ranotokak/K-controller/pics/20200108_173936.jpg

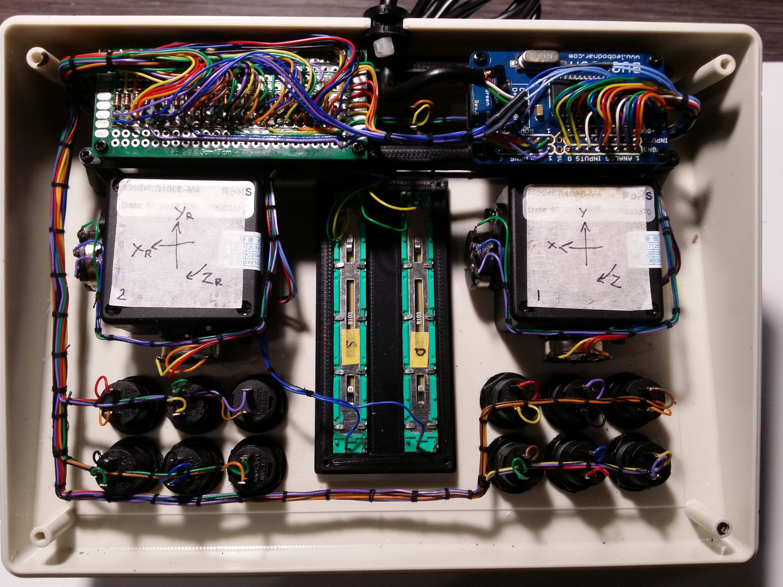
pics/20200108_173936.jpg
