ranotokak/K-controller/pics/20200108_173652.jpg

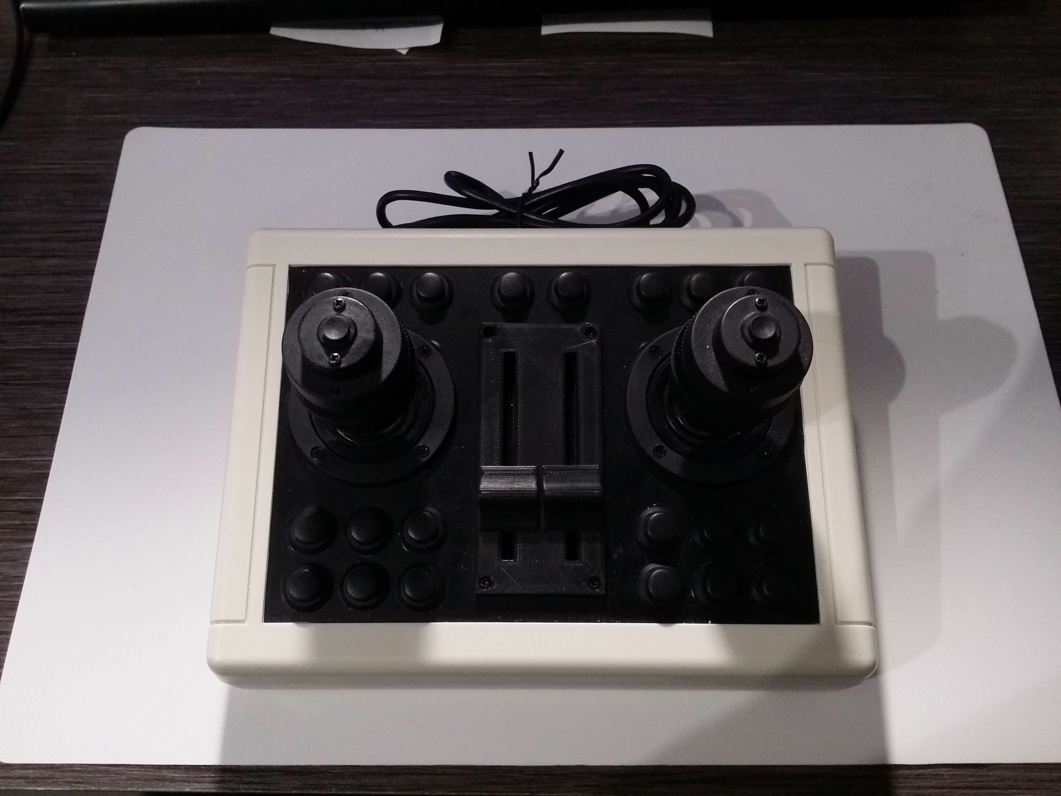
pics/20200108_173652.jpg
