ranotokak/K-controller/README.md

# K-controller
Compact 8 axis game controller for Kerbal Space Program game. Uses two JH-D400X-R4 3 axis joysticks and 2 sliders for control.

* Parts to buy and some links in PartsList.ods
* Read AssemblyNotes.txt before build
