ranotokak/K-controller/PartsList.ods

parts list
BU0836A-NC 12-Bit Joystick Controller No Connectors | http://www.leobodnar.com/shop/index.php?main_page=product_info&cPath=94&products_id=219
Case project box 200*145*63mm | https://www.aliexpress.com/item/32901311993.html
JH-D400X-R4 Joystick | https://www.aliexpress.com/item/32918151242.html
Button Switch 12mm | https://www.aliexpress.com/item/32802331189.html
B10K SC6080GH Potentiometer
3x7cm PCB Breadboard
LL4148 diode
30 AWG 0.25mm wire
M2x10 self-tapping screw
