ranotokak/K-controller/SolidworksFiles/JH-D400X-R4.SLDASM

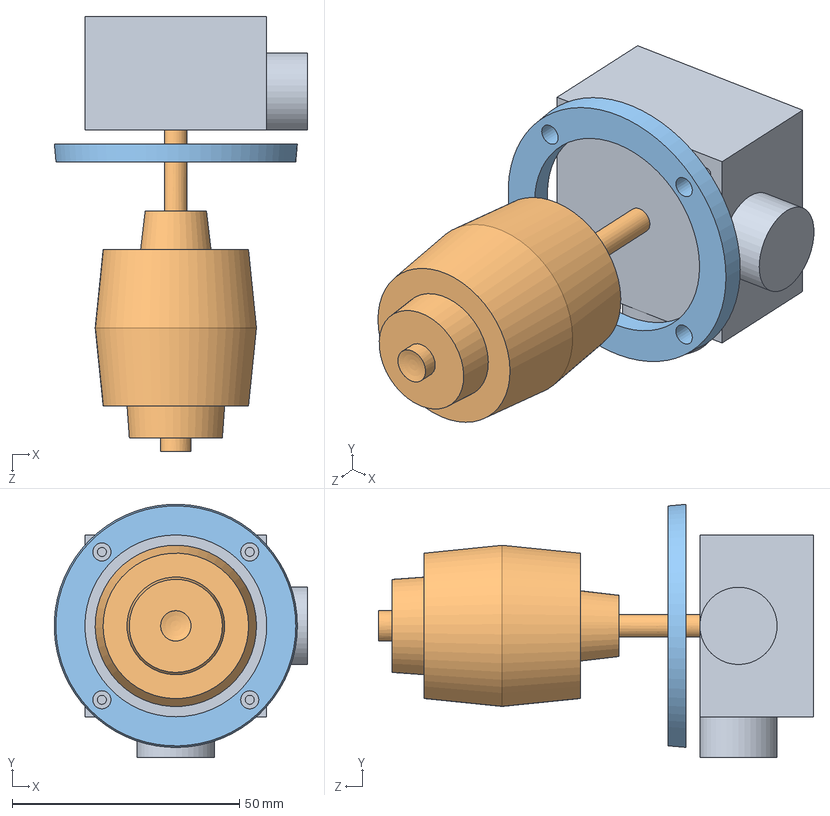
[picture p3: CAD file, 2020-01-08]
SolidworksFiles/JH-D400X-R4.SLDASM
55.7 x 55.7 x 95.7 mm
JH-D400X-R4 part1
JH-D400X-R4 part2
JH-D400X-R4 part3
