ranotokak/K-controller/SolidworksFiles/Assembly.SLDASM

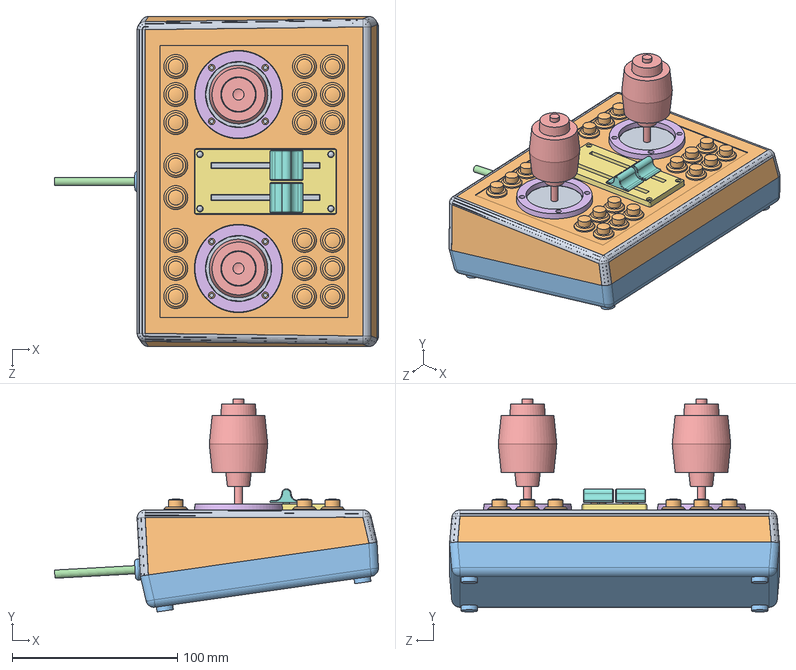
[picture p4: CAD file, 2020-01-08]
SolidworksFiles/Assembly.SLDASM
196.4 x 129.1 x 200.0 mm
CaseUpperWHoles
CaseBottom
B10K SC6080GH x 2
M2x4 screw x 4
SliderBase
SliderTop
Knob x 2
M2x10selftapping x 16
Button x 20
ButtonNut x 20
JH-D400X-R4 part1 x 2
JH-D400X-R4 part2 x 2
JH-D400X-R4 part3 x 2
PcbBaseHolder
PcbStand x 2
pcbBU0836A
pcbBreadboard
cableReliefClamp
cable
