ranotokak/K-controller/SolidworksFiles/Cable.SLDASM

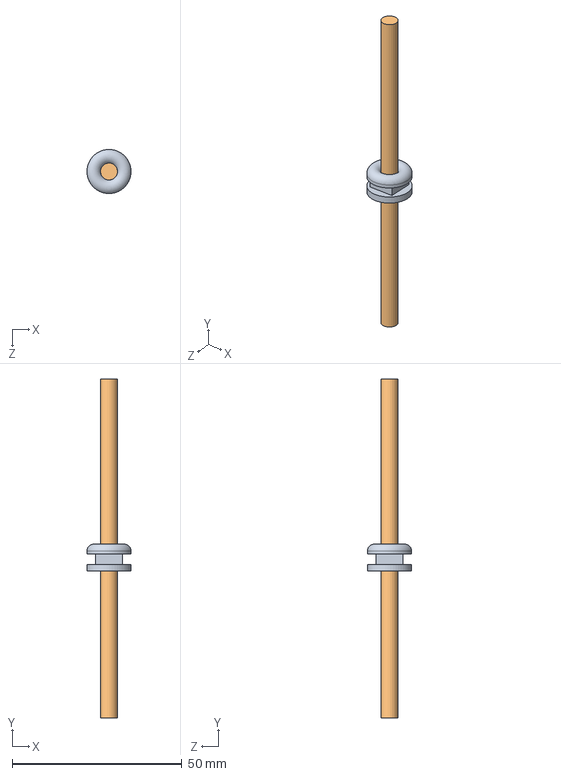
[picture p5: CAD file, 2020-01-08]
SolidworksFiles/Cable.SLDASM
13.0 x 100.0 x 13.0 mm
cableReliefClamp
cable
