ranotokak/K-controller/SolidworksFiles/SliderAssem.SLDASM

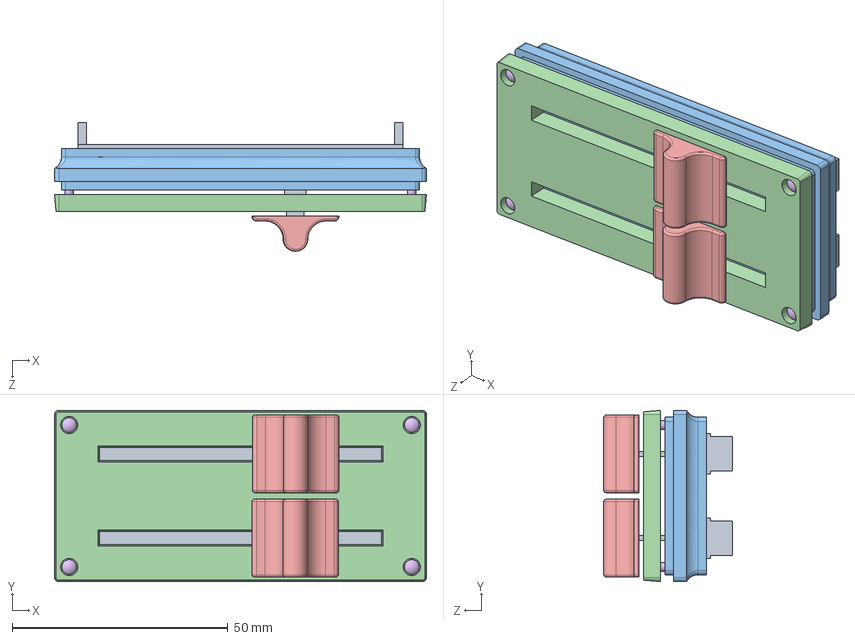
[picture p6: CAD file, 2020-01-08]
SolidworksFiles/SliderAssem.SLDASM
86.2 x 39.7 x 29.8 mm
B10K SC6080GH x 2
M2x4 screw x 4
SliderBase
SliderTop
Knob x 2
M2x10selftapping x 4
