ranotokak/K-controller/SolidworksFiles/CaseUpperWHoles.SLDPRT

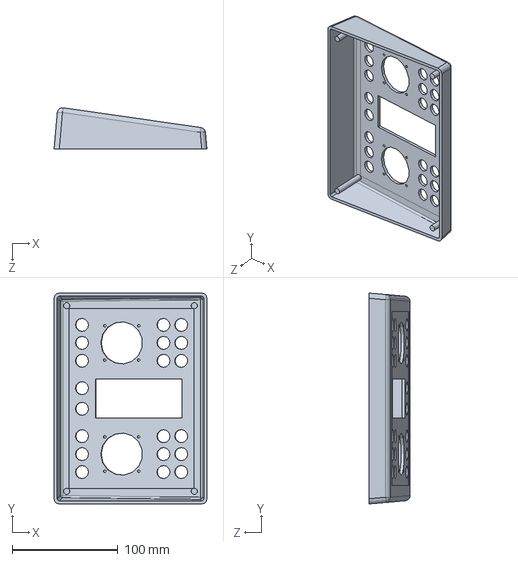
[picture p7: CAD file, 2020-01-08]
SolidworksFiles/CaseUpperWHoles.SLDPRT
145.0 x 200.0 x 39.3 mm
