ranotokak/K-controller/SolidworksFiles/ButtonAssem.SLDASM

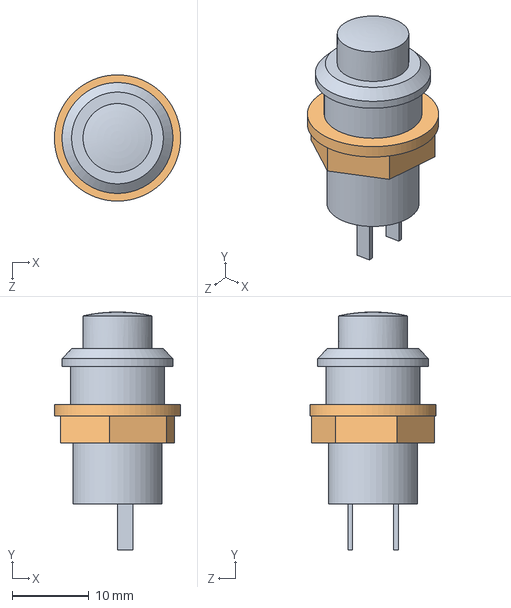
[picture p8: CAD file, 2020-01-08]
SolidworksFiles/ButtonAssem.SLDASM
16.5 x 31.1 x 16.5 mm
Button
ButtonNut
