ranotokak/K-controller/SolidworksFiles/PCBassem.SLDASM

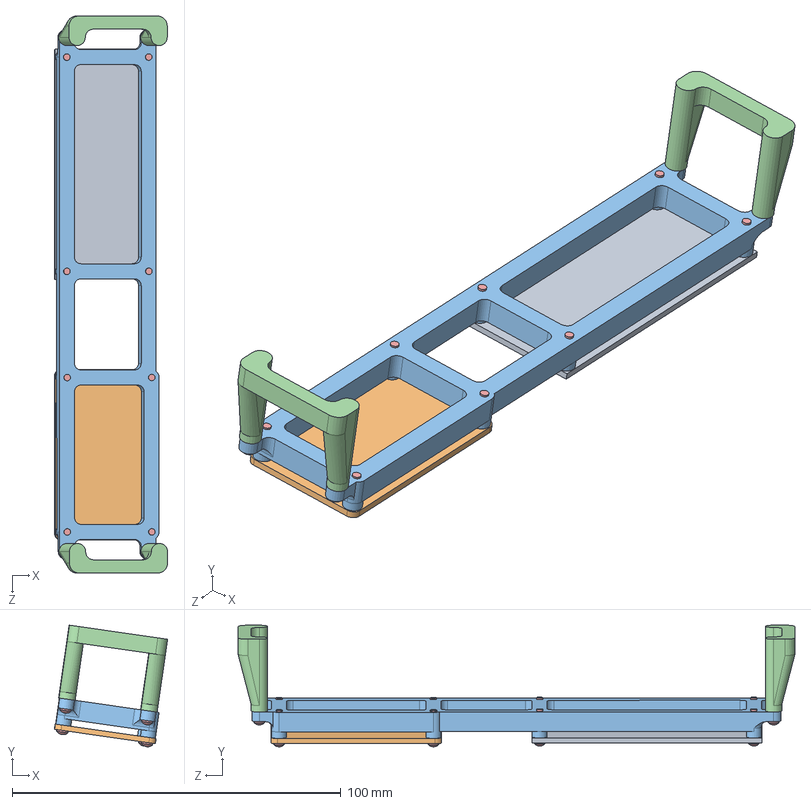
[picture p9: CAD file, 2020-01-08]
SolidworksFiles/PCBassem.SLDASM
34.5 x 37.0 x 169.5 mm
PcbBaseHolder
PcbStand x 2
pcbBU0836A
pcbBreadboard
M2x10selftapping x 12
