ranotokak/K-controller/CaseHolesLayout.DXF

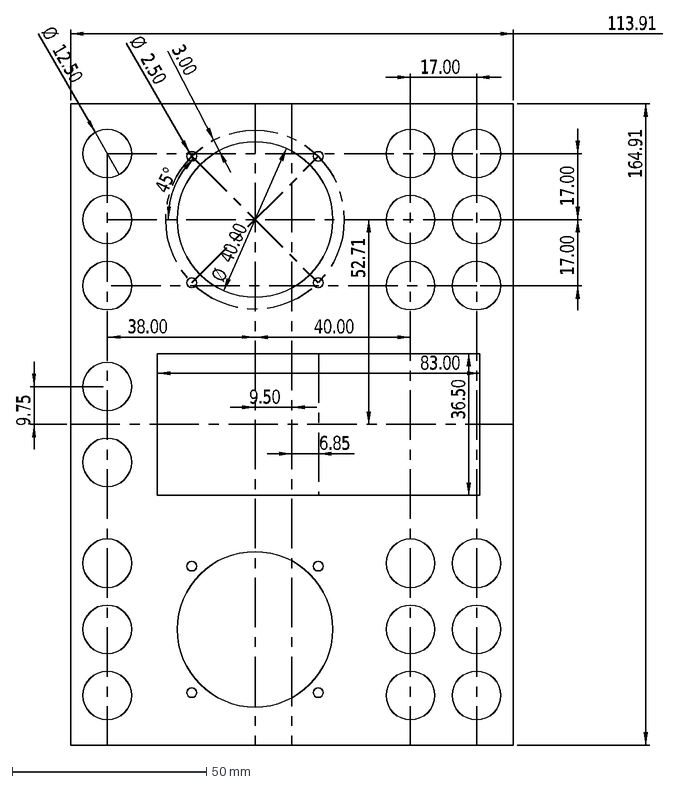
[picture p10: CAD file, 2020-01-08]
CaseHolesLayout.DXF
Ø
12.50
113.91
164.91
40.00
36.50
83.00
52.71
45°
9.50
2.50
38.00
17.00
9.75
6.85
3.00
