ranotokak/K-controller/printed_parts/PcbStand.STL

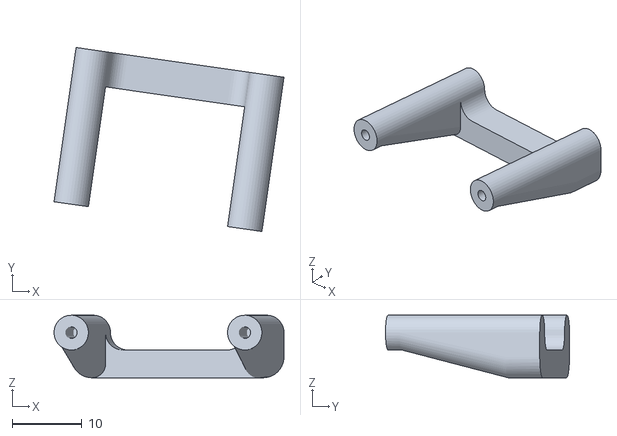
[picture p11: CAD file, 2020-01-08]
printed_parts/PcbStand.STL
33.1 x 26.5 x 9.00
