ranotokak/K-controller/SolidworksFiles/JH-D400X-R4 part2.SLDPRT

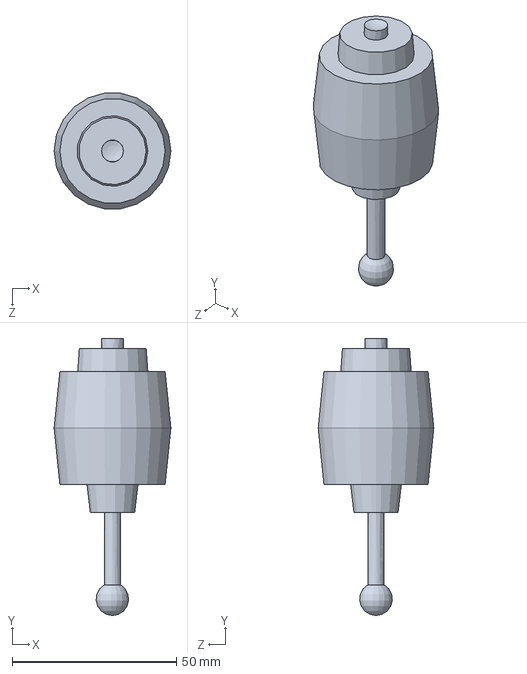
[picture p12: CAD file, 2020-01-08]
SolidworksFiles/JH-D400X-R4 part2.SLDPRT
35.5 x 84.2 x 35.1 mm
