ranotokak/K-controller/printed_parts/cableReliefClamp.STL

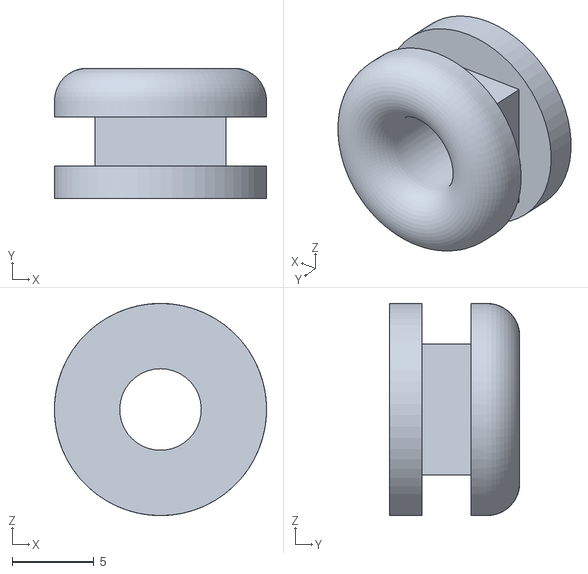
[picture p13: CAD file, 2020-01-08]
printed_parts/cableReliefClamp.STL
13.0 x 8.00 x 13.0
