ranotokak/K-controller/SolidworksFiles/JH-D400X-R4 part3.SLDPRT

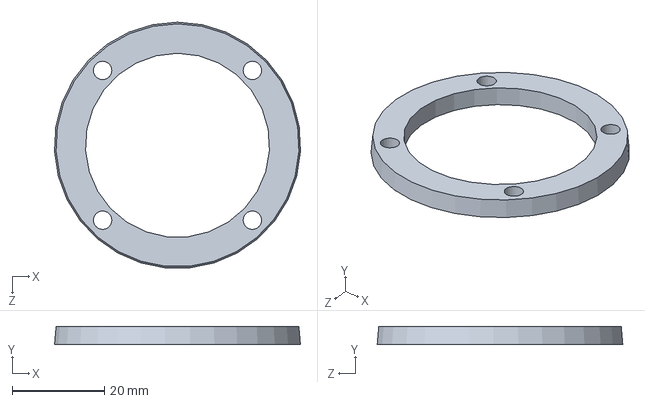
[picture p14: CAD file, 2020-01-08]
SolidworksFiles/JH-D400X-R4 part3.SLDPRT
53.4 x 4.00 x 53.4 mm
