ranotokak/K-controller/printed_parts/SliderBase.STL

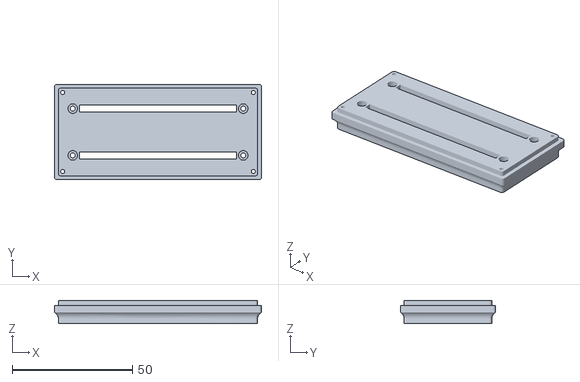
[picture p15: CAD file, 2020-01-08]
printed_parts/SliderBase.STL
86.2 x 39.7 x 9.60
