ranotokak/K-controller/printed_parts/Knob.STL

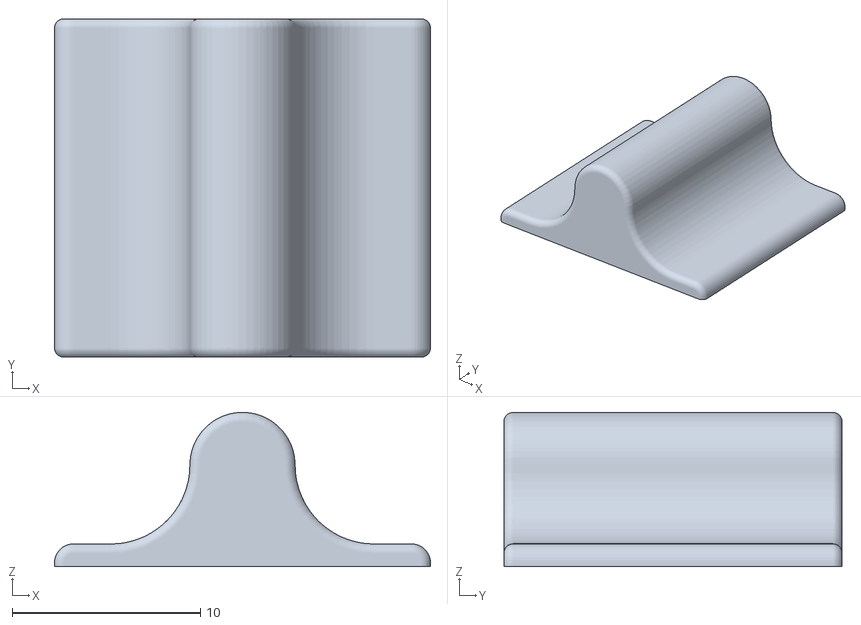
[picture p16: CAD file, 2020-01-08]
printed_parts/Knob.STL
20.0 x 18.0 x 8.19
