ranotokak/K-controller/printed_parts/SliderTop.STL

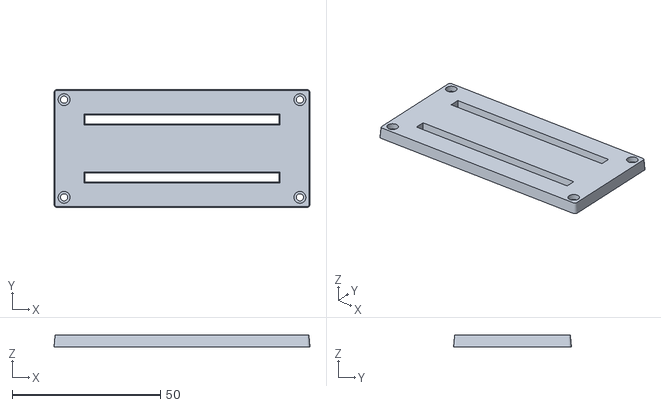
[picture p17: CAD file, 2020-01-08]
printed_parts/SliderTop.STL
86.2 x 39.7 x 4.00
