ranotokak/K-controller/SolidworksFiles/JH-D400X-R4 part1.SLDPRT

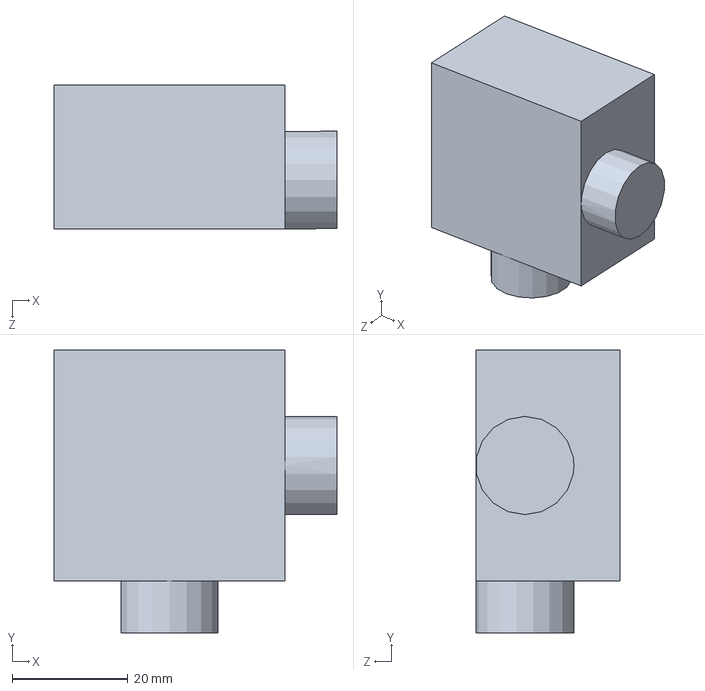
[picture p18: CAD file, 2020-01-08]
SolidworksFiles/JH-D400X-R4 part1.SLDPRT
49.0 x 49.0 x 25.0 mm
