ranotokak/K-controller/printed_parts/PcbBaseHolder.STL

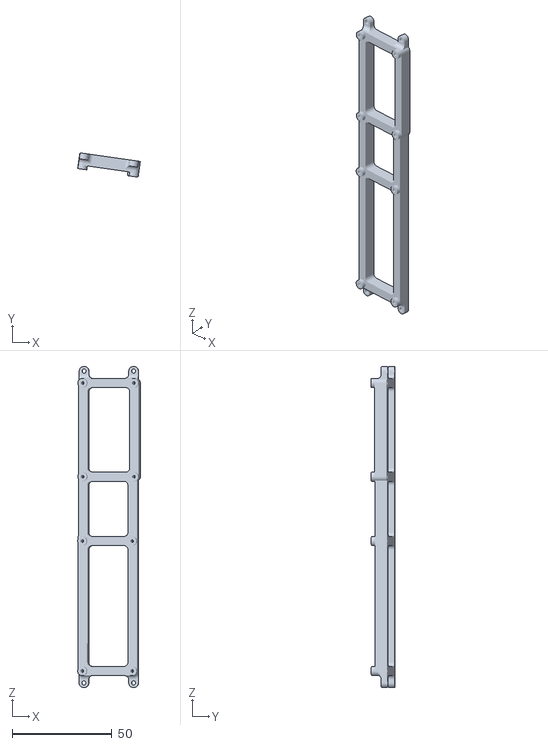
[picture p19: CAD file, 2020-01-08]
printed_parts/PcbBaseHolder.STL
31.5 x 12.3 x 161.1
