ranotokak/K-controller/SolidworksFiles/B10K SC6080GH.SLDPRT

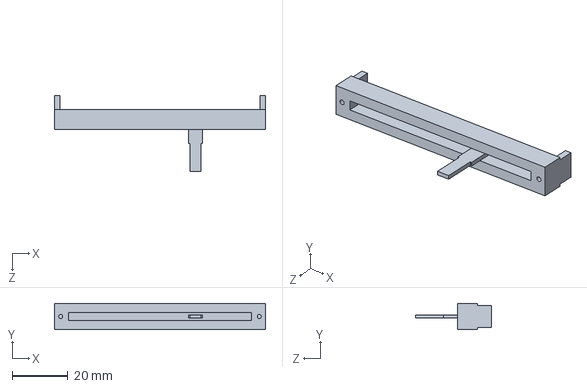
[picture p20: CAD file, 2020-01-08]
SolidworksFiles/B10K SC6080GH.SLDPRT
75.4 x 9.40 x 27.0 mm
