ranotokak/K-controller/SolidworksFiles/CaseBottom.SLDPRT

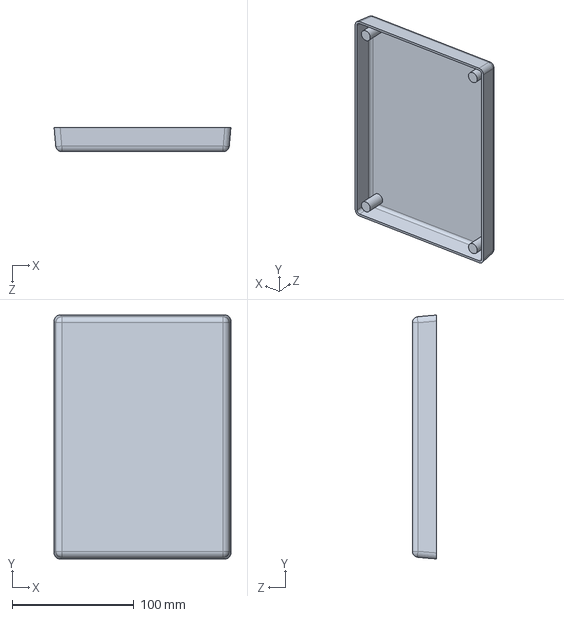
[picture p21: CAD file, 2020-01-08]
SolidworksFiles/CaseBottom.SLDPRT
145.0 x 200.0 x 20.0 mm
