ranotokak/K-controller/SolidworksFiles/Button.SLDPRT

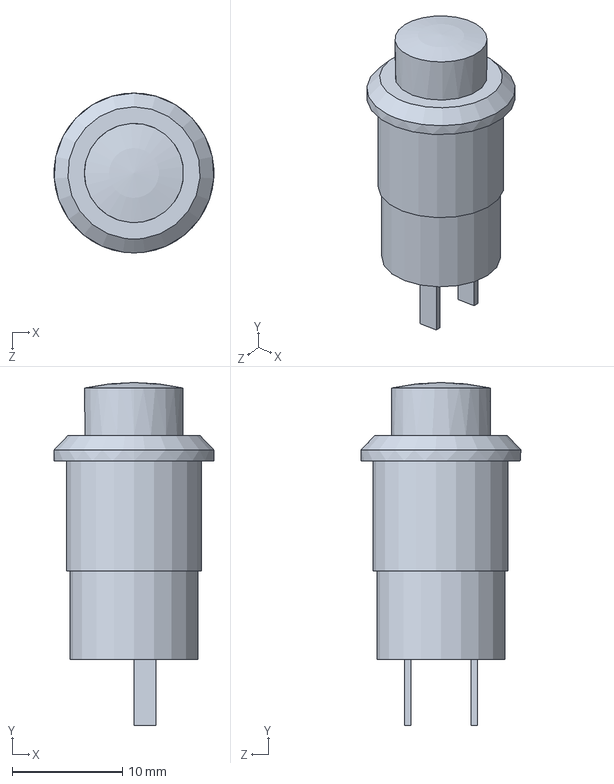
[picture p22: CAD file, 2020-01-08]
SolidworksFiles/Button.SLDPRT
14.5 x 31.1 x 14.5 mm
