ranotokak/K-controller/SolidworksFiles/pcbBU0836A.SLDPRT

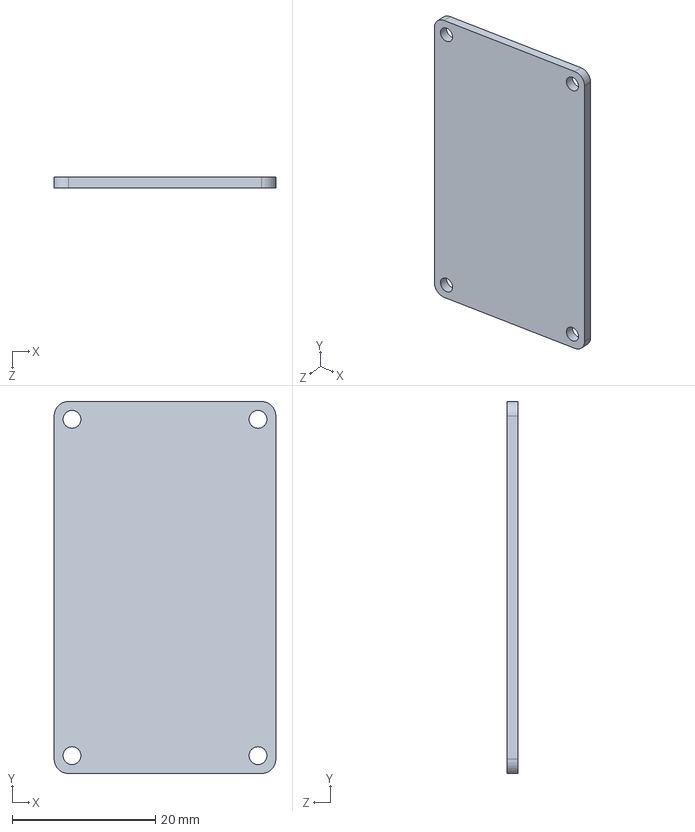
[picture p23: CAD file, 2020-01-08]
SolidworksFiles/pcbBU0836A.SLDPRT
31.0 x 52.0 x 1.60 mm
