ranotokak/K-controller/SolidworksFiles/Knob.sldprt

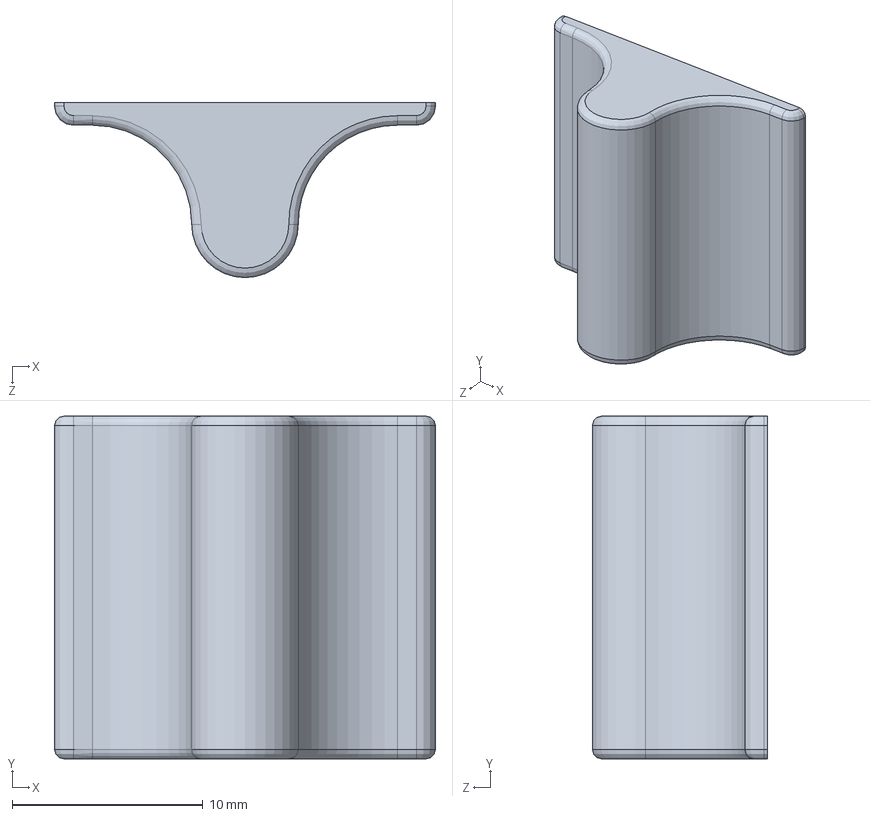
[picture p24: CAD file, 2020-01-08]
SolidworksFiles/Knob.sldprt
20.0 x 18.0 x 9.20 mm
