ranotokak/K-controller/SolidworksFiles/pcbBreadboard.SLDPRT

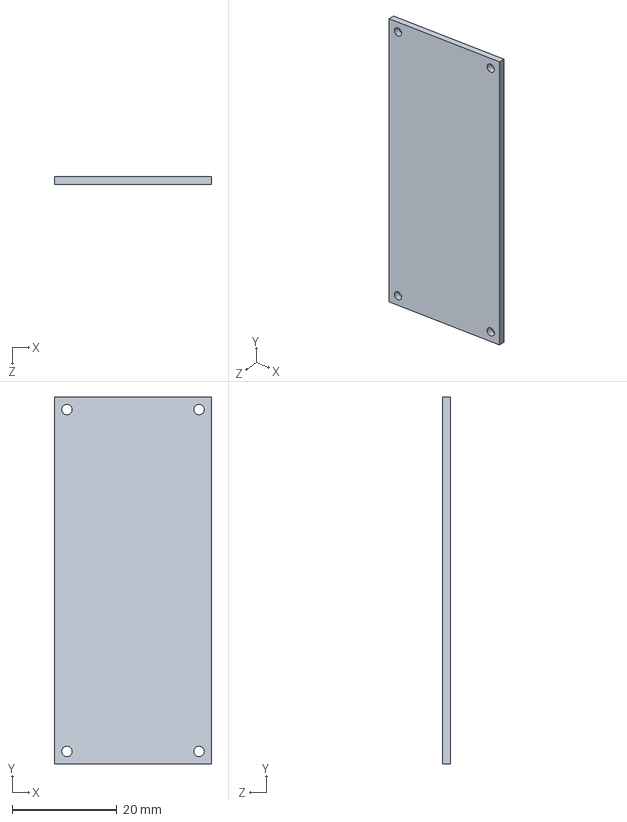
[picture p25: CAD file, 2020-01-08]
SolidworksFiles/pcbBreadboard.SLDPRT
30.0 x 70.0 x 1.50 mm
