ranotokak/K-controller/SolidworksFiles/CaseUpper.SLDPRT

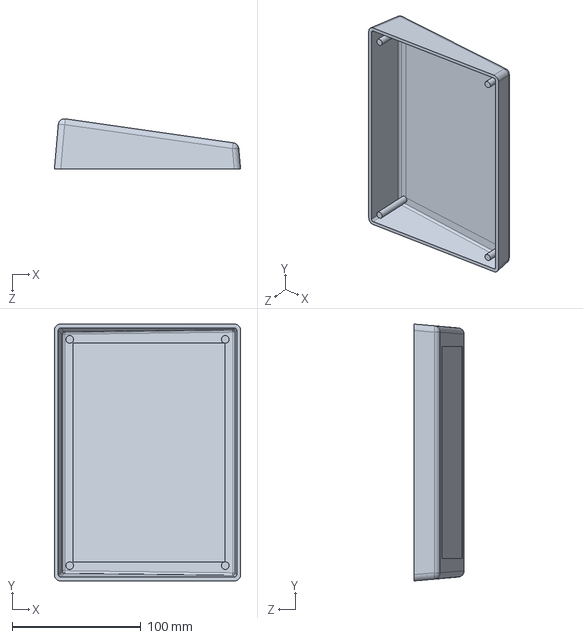
[picture p26: CAD file, 2020-01-08]
SolidworksFiles/CaseUpper.SLDPRT
145.0 x 200.0 x 39.3 mm
