ranotokak/K-controller/SolidworksFiles/ButtonNut.SLDPRT

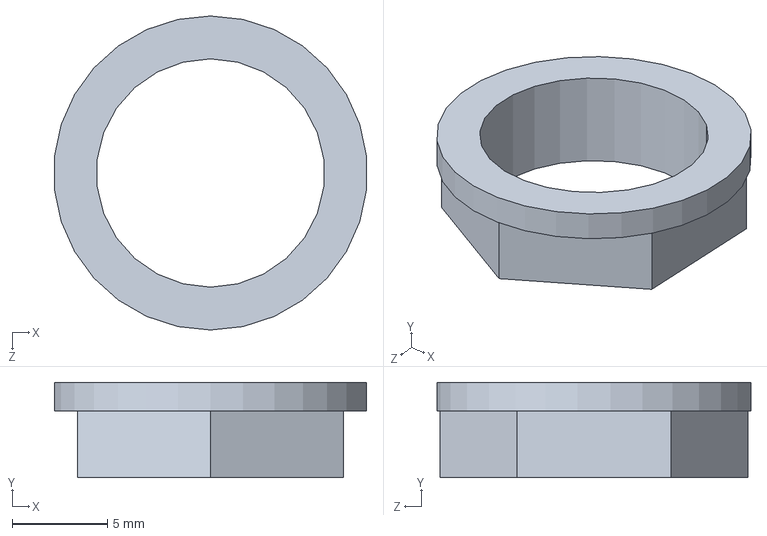
[picture p27: CAD file, 2020-01-08]
SolidworksFiles/ButtonNut.SLDPRT
16.4 x 5.00 x 16.5 mm
