ranotokak/K-controller/(list of files, cad)

Other CAD files:
SolidworksFiles/SliderBase.sldprt
SolidworksFiles/PcbStand.sldprt
SolidworksFiles/PcbBaseHolder.sldprt
SolidworksFiles/SliderTop.sldprt
SolidworksFiles/cableReliefClamp.SLDPRT
SolidworksFiles/CaseHolesLayout.SLDDRW
SolidworksFiles/M2x10selftapping.SLDPRT
SolidworksFiles/M2x4 screw.SLDPRT
SolidworksFiles/cable.SLDPRT
