ranotokak/K-controller/SliderAssembly.pdf

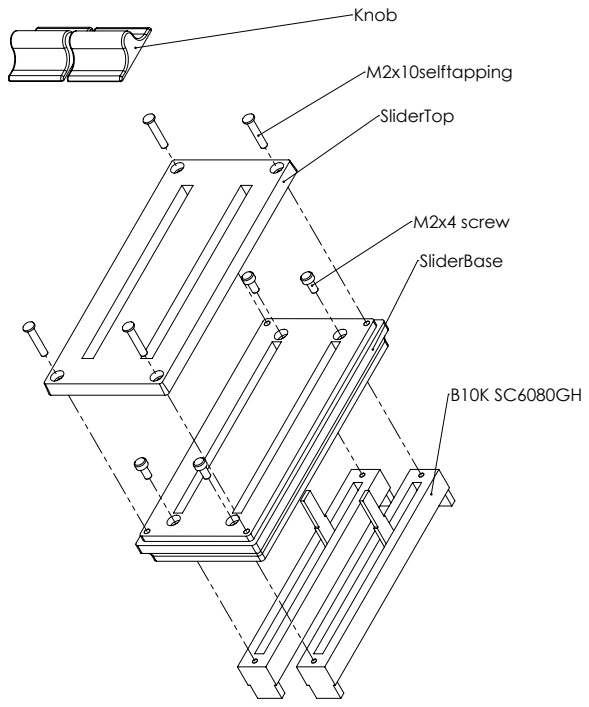
[picture p28: page 1]
M2x4 screw
