ranotokak/K-controller/ButtonMatrixPCB.pdf

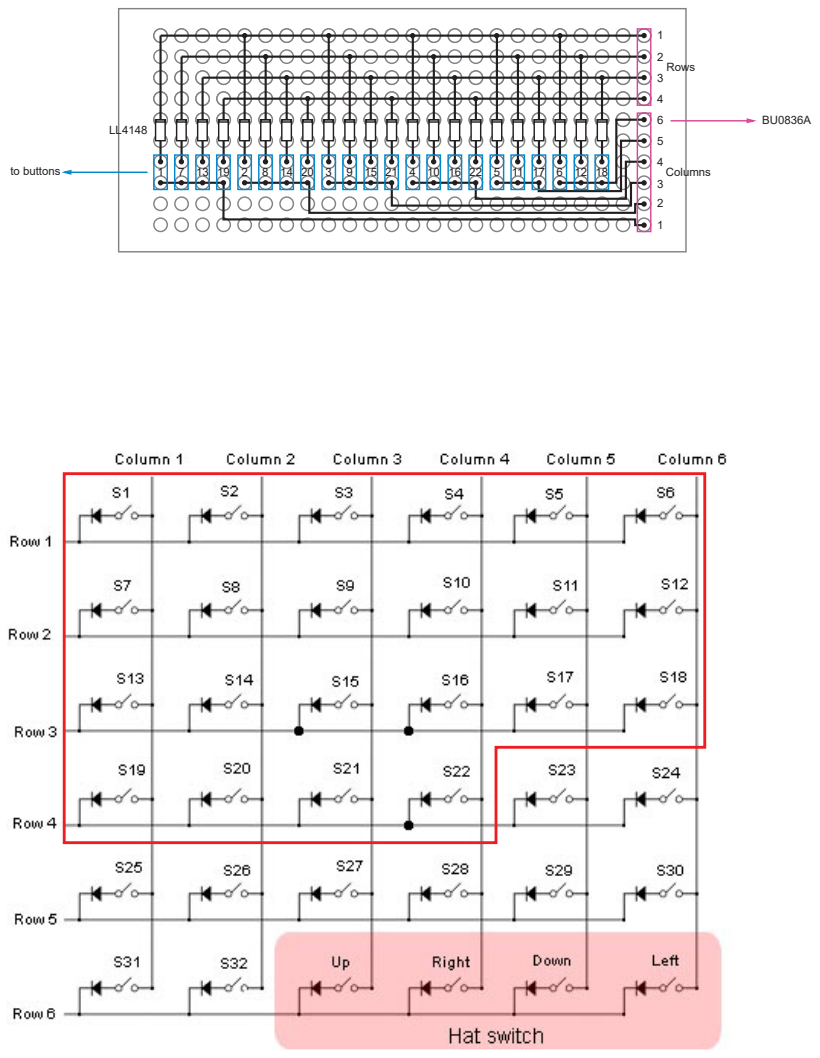
[picture p29: page 1]
to buttons; Rows; Columns
