ranotokak/K-controller/Assembly.pdf

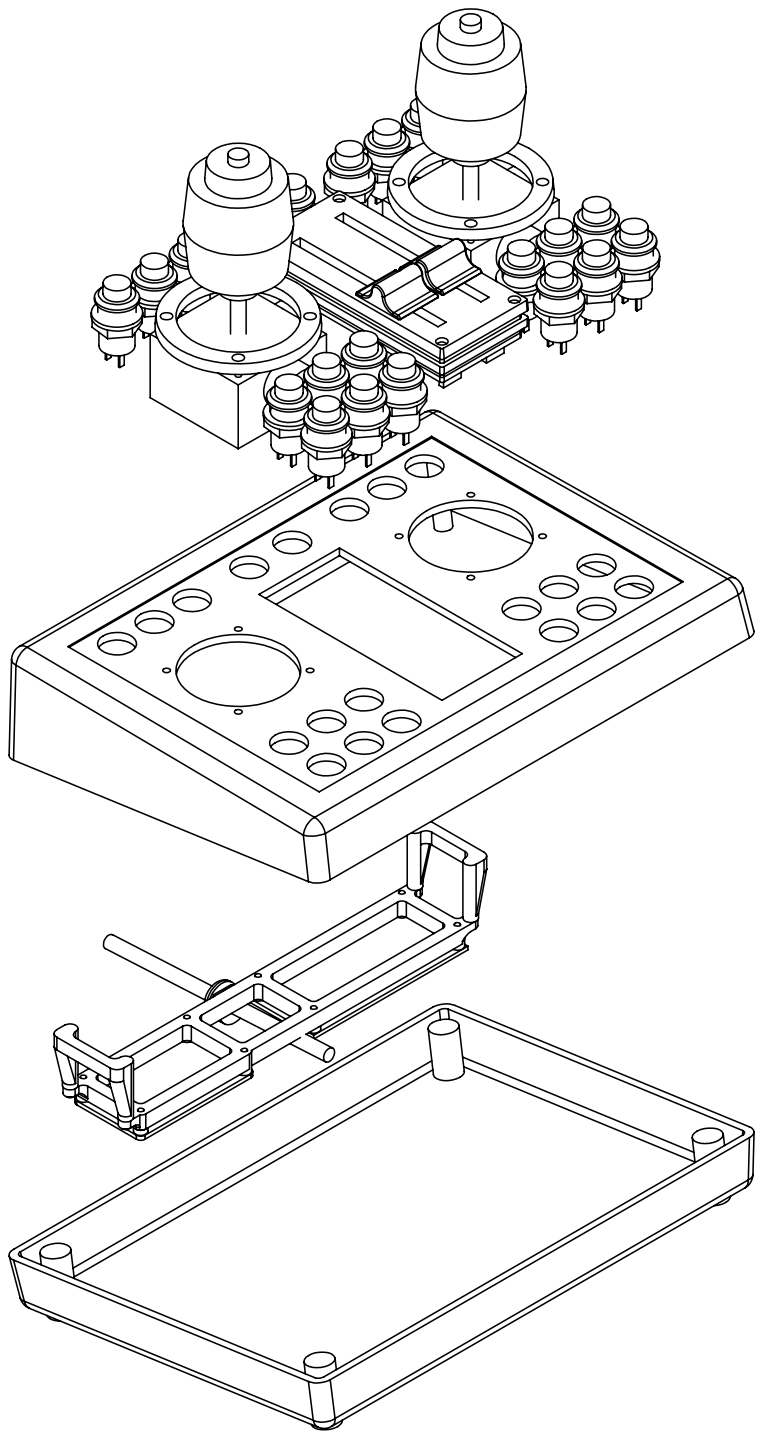
[picture p30: page 1]
