ranotokak/K-controller/CaseHolesLayout.pdf

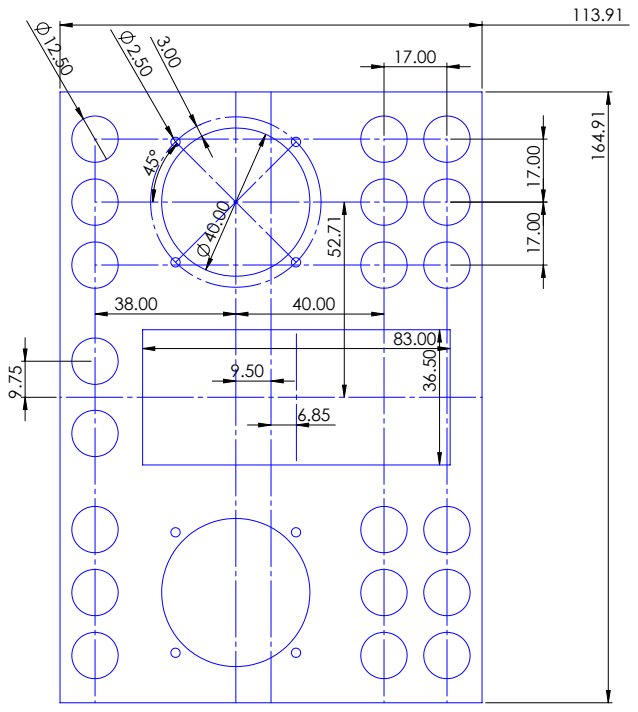
[picture p31: page 1]

9.50
6.85
